akosturi/bitsynth/schematic/wiring.jpg

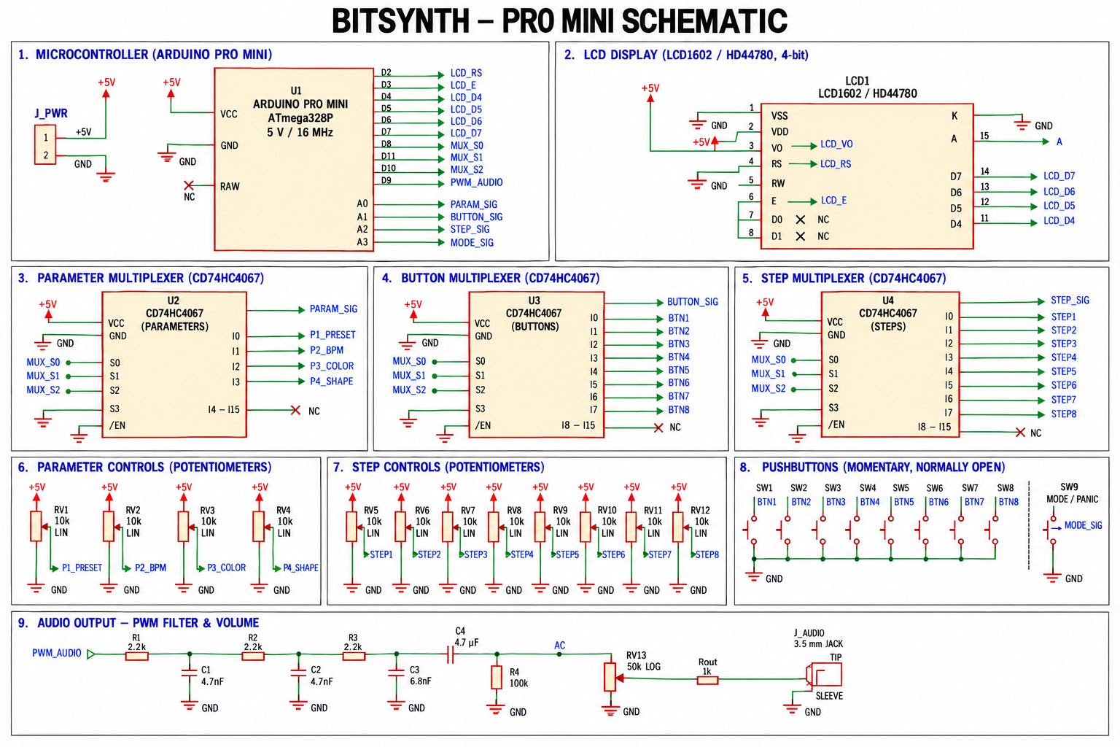
schematic/wiring.jpg
