akosturi/bitsynth/03.jpg

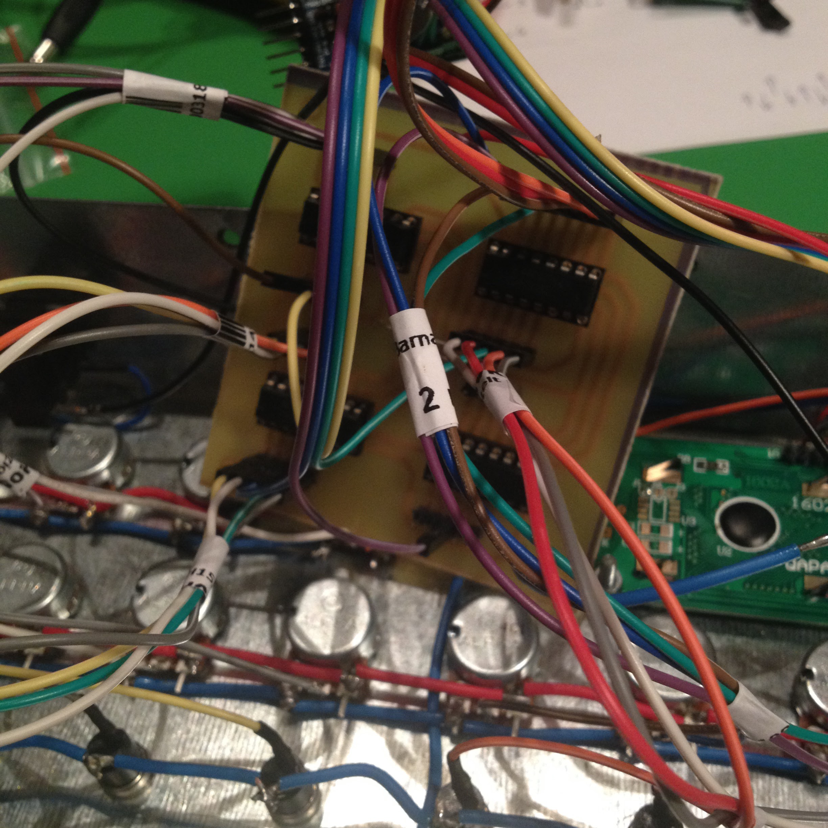
03.jpg
