akosturi/bitsynth/01.jpg

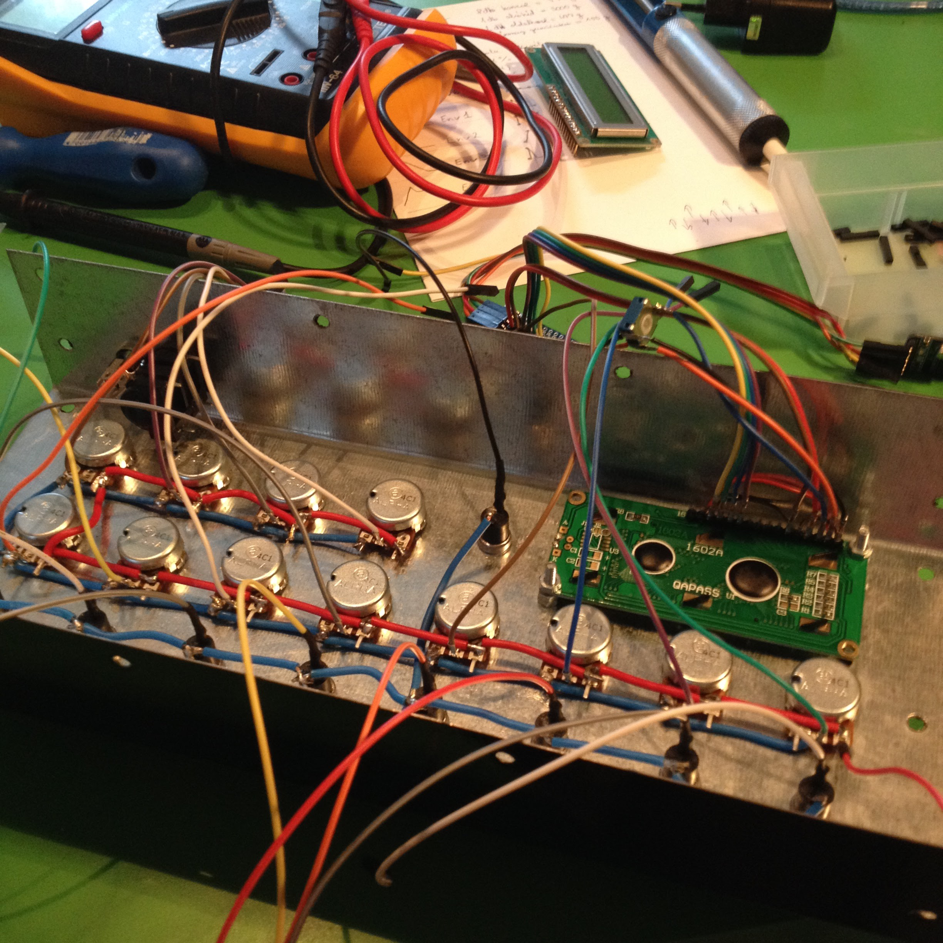
01.jpg
