akosturi/bitsynth/02.jpg

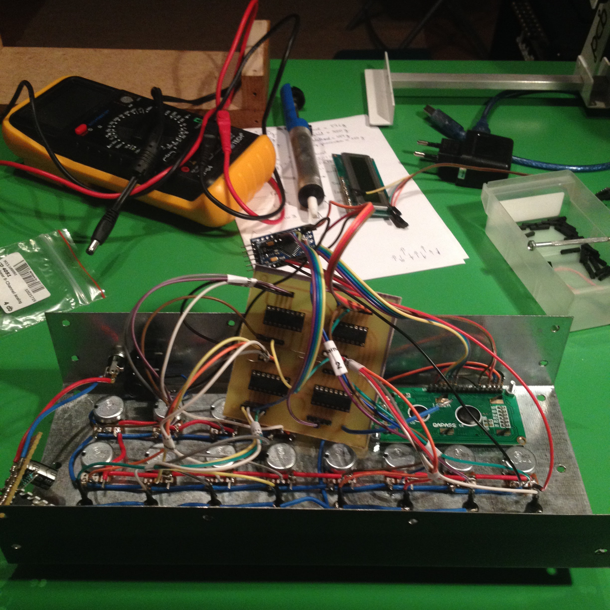
02.jpg
