akosturi/bitsynth/schematic/envelopes.jpg

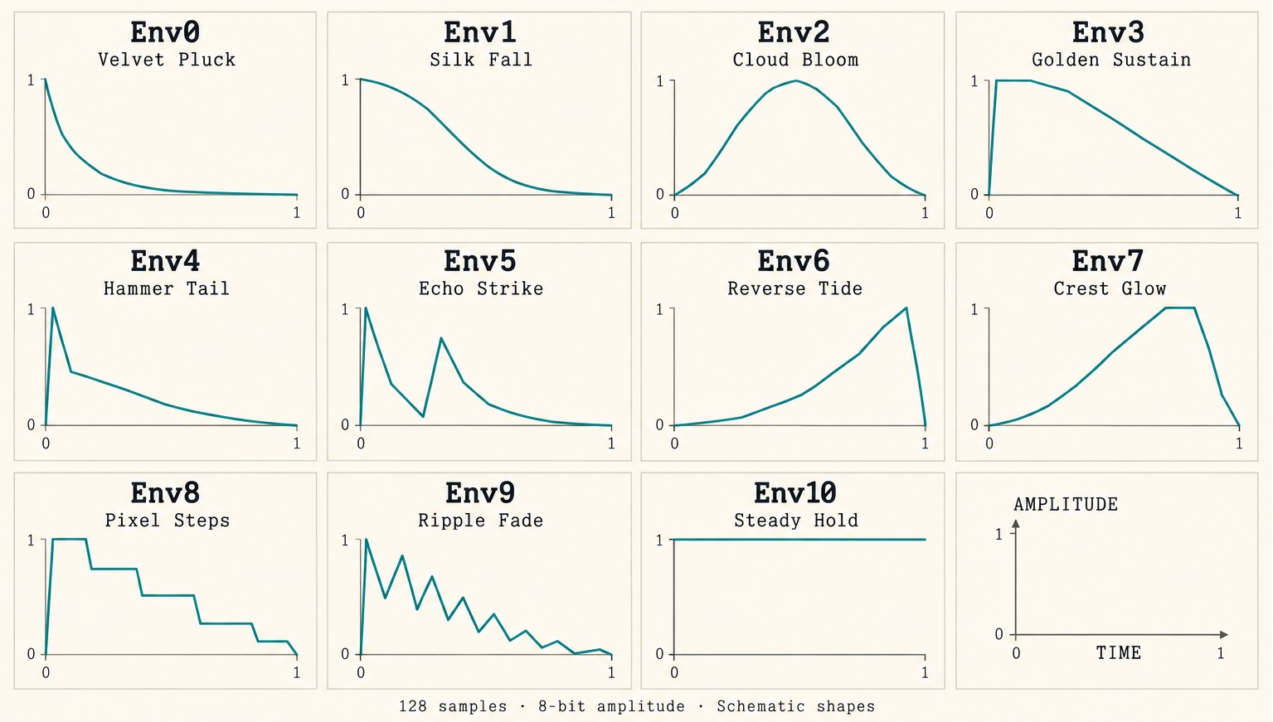
schematic/envelopes.jpg
