akosturi/bitsynth/schematic/wiring.kicad_pcb

## KiCad design schematic/wiring.kicad_pcb (2026-10-29)

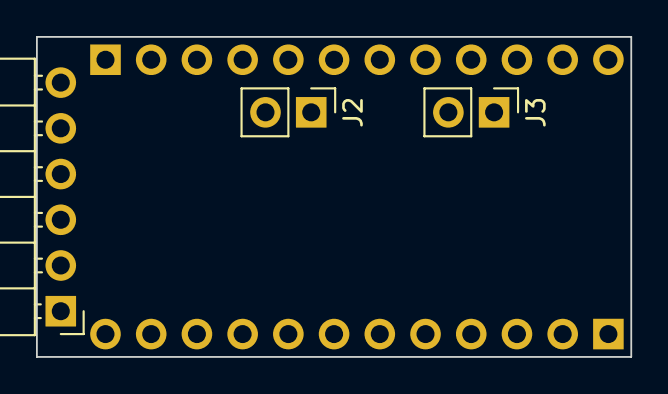
[picture p6: board wiring.kicad_pcb from above]

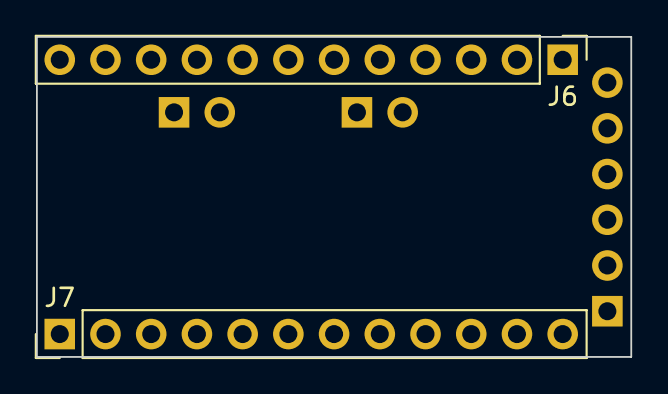
[picture p7: board wiring.kicad_pcb from below]

Board: 2 copper layers, 33.0 x 17.8 mm, 5 parts (2 on the bottom side), 5 nets, no tracks yet.

Parts:
J1: FTDI; PinHeader_1x06_P2.54mm_Horizontal
J2: I2C; PinHeader_1x02_P2.54mm_Vertical
J3: Analog; PinHeader_1x02_P2.54mm_Vertical
J6: Analog; PinHeader_1x12_P2.54mm_Vertical
J7: Digital; PinHeader_1x12_P2.54mm_Vertical

Connections:
/RX: J1.4, J7.11
/TX: J1.5, J7.12
/~RESET: J6.3, J7.10
GND: J1.1, J1.2, J6.2, J7.9
VCC: J1.3, J6.4
