akosturi/bitsynth/src/synth.h

#ifndef _SYNTH
#define _SYNTH
#include <Arduino.h>
#include <avr/pgmspace.h>
#include <avr/interrupt.h>
#include <util/atomic.h>
#include "tables.h"

#ifndef F_CPU
#define F_CPU 16000000UL
#endif

#define DIFF 1
#define CHA 2
#define CHB 3

#define SINE     0
#define TRIANGLE 1
#define SQUARE   2
#define SAW      3
#define NOISE    4

#define ENVELOPE0 0
#define ENVELOPE1 1
#define ENVELOPE2 2
#define ENVELOPE3 3
#define ENVELOPE4 4
#define ENVELOPE5 5
#define ENVELOPE6 6
#define ENVELOPE7 7

#define FS 20000UL

#if defined(SYNTH_FIXED_OUTPUT_MODE) && \
    SYNTH_FIXED_OUTPUT_MODE != DIFF && \
    SYNTH_FIXED_OUTPUT_MODE != CHA && \
    SYNTH_FIXED_OUTPUT_MODE != CHB
#error "SYNTH_FIXED_OUTPUT_MODE must be DIFF, CHA, or CHB"
#endif

static_assert(kickSampleRate == FS, "kick sample rate must match the 20 kHz audio engine");
static_assert(snareSampleRate == FS, "snare sample rate must match the 20 kHz audio engine");
static_assert(hihatSampleRate == FS, "hi-hat sample rate must match the 20 kHz audio engine");
static_assert(kickSampleBits == 9, "kick sample must use unsigned 9-bit PCM");
static_assert(snareSampleBits == 9, "snare sample must use unsigned 9-bit PCM");
static_assert(hihatSampleBits == 9, "hi-hat sample must use unsigned 9-bit PCM");
// One trailing byte makes the final unaligned 16-bit flash read safe.
static_assert(sizeof(kickSample) == (kickSampleLength * 9U + 7U) / 8U + 1U, "invalid packed kick sample size");
static_assert(sizeof(snareSample) == (snareSampleLength * 9U + 7U) / 8U + 1U, "invalid packed snare sample size");
static_assert(sizeof(hihatSample) == (hihatSampleLength * 9U + 7U) / 8U + 1U, "invalid packed hi-hat sample size");

#define SET(x,y) (x |= (1 << y))
#define CLR(x,y) (x &= (~(1 << y)))

const uint8_t SYNTH_VOICE_COUNT = 4;
const uint8_t SYNTH_DRONE_COUNT = 8;
const uint8_t SYNTH_MIDI_NOTE_MAX = 127;
const uint8_t SYNTH_LENGTH_MAX = 127;
const uint8_t SYNTH_ENVELOPE_COUNT = 6;
const uint8_t SYNTH_WAVETABLE_INDEX_BITS = 8;
const uint8_t SYNTH_WAVETABLE_SHIFT = 16 - SYNTH_WAVETABLE_INDEX_BITS;
const uint16_t SYNTH_GENERATED_SQUARE = 0;
// Flash on this target cannot reach this address; reserve it as a generated
// source marker rather than spending flash on a noise wavetable.
const uint16_t SYNTH_GENERATED_NOISE = 0xFFFF;
const uint16_t SYNTH_DEFAULT_PULSE_WIDTH = 0x8000;
// Updated once per four audio frames (5 kHz), giving a fixed 5 Hz vibrato.
const uint32_t SYNTH_VIBRATO_LFO_STEP = 4294967UL;
const uint8_t SYNTH_CHORUS_OFF = 0;
const uint8_t SYNTH_CHORUS_1 = 1;
const uint8_t SYNTH_CHORUS_2 = 2;
// Juno-60-style triangle-modulated delay parameters at the 20 kHz engine rate.
const uint16_t SYNTH_CHORUS_BUFFER_SAMPLES = 108;
const uint32_t SYNTH_CHORUS_1_LFO_STEP = 110166UL; // 0.513 Hz
const uint32_t SYNTH_CHORUS_2_LFO_STEP = 185328UL; // 0.863 Hz
const uint16_t SYNTH_CHORUS_MIN_DELAY_Q8 = 8500; // 1.66 ms

static_assert(sizeof(SinTable) / sizeof(SinTable[0]) == (1U << SYNTH_WAVETABLE_INDEX_BITS), "invalid sine table size");
static_assert(sizeof(TriangleTable) / sizeof(TriangleTable[0]) == (1U << SYNTH_WAVETABLE_INDEX_BITS), "invalid triangle table size");
static_assert(sizeof(SawTable) / sizeof(SawTable[0]) == (1U << SYNTH_WAVETABLE_INDEX_BITS), "invalid saw table size");

volatile uint16_t PCW[SYNTH_VOICE_COUNT] = {0, 0, 0, 0};
volatile uint16_t FTW[SYNTH_VOICE_COUNT] = {1000, 200, 300, 400};
volatile uint8_t AMP[SYNTH_VOICE_COUNT] = {0, 0, 0, 0};
volatile uint16_t PITCH[SYNTH_VOICE_COUNT] = {500, 500, 500, 500};
volatile int8_t MOD[SYNTH_VOICE_COUNT] = {0, 0, 0, 0};
volatile uint32_t vibratoLfoPCW = 0x40000000UL;
volatile uint16_t waveSources[SYNTH_VOICE_COUNT] = {
  (uint16_t)SinTable, (uint16_t)SinTable, (uint16_t)SinTable, (uint16_t)SinTable
};
// Full phase resolution makes pulse width independent from wavetable size.
volatile uint16_t pulseWidths[SYNTH_VOICE_COUNT] = {
  SYNTH_DEFAULT_PULSE_WIDTH, SYNTH_DEFAULT_PULSE_WIDTH,
  SYNTH_DEFAULT_PULSE_WIDTH, SYNTH_DEFAULT_PULSE_WIDTH
};
volatile uint16_t envs[SYNTH_VOICE_COUNT] = {
  (uint16_t)Env0, (uint16_t)Env0, (uint16_t)Env0, (uint16_t)Env0
};
volatile uint16_t EPCW[SYNTH_VOICE_COUNT] = {0x8000, 0x8000, 0x8000, 0x8000};
volatile uint16_t EFTW[SYNTH_VOICE_COUNT] = {10, 10, 10, 10};
volatile uint8_t divider = 4;
volatile int16_t pwmQuantizationError = 0;
volatile uint8_t pwmDitherLfsr = 0xA5;
// Independent maximal-length 16-bit Galois LFSRs for the four normal voices.
// These are advanced only by the audio ISR and must never be seeded with zero.
volatile uint16_t noiseLfsrs[SYNTH_VOICE_COUNT] = {
  0xA5C3, 0xD72B, 0x9E37, 0xF1A5
};
// Retained performance engines. Their UI routing is intentionally disabled
// for now, but presets still configure the VCA defaults.
volatile bool playMorphActive = false;
volatile uint16_t playMorphSource = (uint16_t)SinTable;
volatile uint32_t playMorphLfoPCW = 0x80000000UL;
volatile uint32_t playMorphLfoFTW = 0;
volatile uint8_t playMorphAmount = 128;
volatile uint16_t playVcaGain = 256;
volatile uint16_t playVcaAttenuationDepth = 0;
volatile uint32_t playVcaLfoPCW = 0x80000000UL;
volatile uint32_t playVcaLfoFTW = 0;
uint8_t playLfoDivider = 0;
volatile bool droneMode = false;
volatile uint16_t dronePCW[SYNTH_DRONE_COUNT] = {0, 0, 0, 0, 0, 0, 0, 0};
volatile uint16_t droneFTW[SYNTH_DRONE_COUNT] = {0, 0, 0, 0, 0, 0, 0, 0};
volatile uint16_t droneWaveSources[SYNTH_DRONE_COUNT] = {
  (uint16_t)SinTable, (uint16_t)SinTable, (uint16_t)SinTable, (uint16_t)SinTable,
  (uint16_t)SinTable, (uint16_t)SinTable, (uint16_t)SinTable, (uint16_t)SinTable
};
volatile uint8_t droneAmp[SYNTH_DRONE_COUNT] = {0, 0, 0, 0, 0, 0, 0, 0};
volatile uint8_t droneTargetAmp[SYNTH_DRONE_COUNT] = {0, 0, 0, 0, 0, 0, 0, 0};
volatile uint8_t droneRampVoice = 0;
volatile uint8_t droneMixPair = 0;
volatile int16_t dronePairMixQ7[SYNTH_DRONE_COUNT / 2] = {0, 0, 0, 0};
volatile uint32_t droneLfoPCW[SYNTH_DRONE_COUNT / 2] = {0, 0, 0, 0};
volatile uint32_t droneLfoFTW[SYNTH_DRONE_COUNT / 2] = {0, 0, 0, 0};
volatile bool drumActive = false;
volatile uint16_t drumSampleAddress = 0;
volatile uint16_t drumSampleLength = 0;
volatile uint32_t drumSamplePhase = 0;
volatile uint32_t drumSampleStep = 0x10000UL;
volatile uint16_t drumEnvelope = 0;
volatile uint16_t drumEnvelopeStep = 1;
// One 16-bit Q7 mono delay line, written only by the audio ISR. It stores the
// wet half of the signal, so interpolating adjacent samples stays in int16_t.
int16_t chorusBuffer[SYNTH_CHORUS_BUFFER_SAMPLES] = {0};
volatile bool chorusActive = false;
volatile bool chorusLiveOnly = false;
volatile uint16_t chorusWriteIndex = 0;
volatile uint32_t chorusLfoPCW = 0;
volatile uint32_t chorusLfoFTW = 0;

static inline __attribute__((always_inline)) int16_t readSigned9Sample(
  uint16_t sampleAddress, uint16_t sampleIndex)
{
  return (int16_t)pgm_read_word(sampleAddress + (sampleIndex << 1));
}

static inline __attribute__((always_inline)) int16_t generatedSquareSample(
  uint16_t phase, uint16_t pulseWidth)
{
  return phase < pulseWidth ? 255 : -256;
}

static inline __attribute__((always_inline)) int16_t nextNoiseSample(uint8_t voice)
{
  const uint16_t state = noiseLfsrs[voice];
  const uint16_t next = (state >> 1) ^ ((state & 1) ? 0xB400 : 0);
  noiseLfsrs[voice] = next;
  return (int16_t)(next & 0x01FF) - 256;
}

static inline __attribute__((always_inline)) int16_t nextWaveSample(
  uint8_t voice, uint16_t source, uint16_t phase, uint16_t pulseWidth)
{
  if (source == SYNTH_GENERATED_SQUARE) {
    return generatedSquareSample(phase, pulseWidth);
  }
  if (source == SYNTH_GENERATED_NOISE) {
    return nextNoiseSample(voice);
  }
  return readSigned9Sample(source, phase >> SYNTH_WAVETABLE_SHIFT);
}

// Decodes an offset-binary unsigned 9-bit sample packed across byte boundaries.
static inline __attribute__((always_inline)) int16_t readPackedUnsigned9Sample(
  uint16_t sampleAddress, uint16_t sampleIndex)
{
  const uint16_t byteIndex = sampleIndex + (sampleIndex >> 3);
  const uint8_t shift = sampleIndex & 0x07;
  const uint16_t packed = pgm_read_word(sampleAddress + byteIndex);
  const uint16_t encoded = (packed >> shift) & 0x01FF;
  return (int16_t)encoded - 256;
}

// Scales a signed sample with arithmetic-shift rounding.
static inline __attribute__((always_inline)) int16_t scaleSigned9Sample(
  int16_t sample, uint8_t gain, uint8_t shift)
{
  const bool negative = sample < 0;
  const uint16_t magnitude = negative ? -sample : sample;
  uint16_t product = magnitude * gain;
  if (negative) {
    product += (1U << shift) - 1U;
    return -(int16_t)(product >> shift);
  }
  return product >> shift;
}

// Keeps phase continuity for silent voices without reading or scaling a table.
static inline __attribute__((always_inline)) int16_t nextScaledVoiceSample(
  uint8_t voice, uint8_t gain)
{
  const uint16_t phase = PCW[voice] + FTW[voice];
  PCW[voice] = phase;
  if (gain == 0) {
    return 0;
  }
  const uint16_t source = waveSources[voice];
  const int16_t sample = nextWaveSample(voice, source, phase, pulseWidths[voice]);
  return scaleSigned9Sample(sample, gain, 3);
}

static inline __attribute__((always_inline)) int16_t nextScaledMorphedVoiceSample(
  uint8_t voice, uint16_t secondarySource, uint8_t morphAmount, uint8_t gain)
{
  const uint16_t phase = PCW[voice] + FTW[voice];
  PCW[voice] = phase;
  if (gain == 0) return 0;
  const int16_t sampleA = nextWaveSample(voice, waveSources[voice], phase, pulseWidths[voice]);
  const int16_t sampleB = nextWaveSample(voice, secondarySource, phase, pulseWidths[voice]);
  const uint8_t primaryAmount = 128 - morphAmount;
  return scaleSigned9Sample(((sampleA * primaryAmount) + (sampleB * morphAmount)) >> 7, gain, 3);
}

// Applies a 9-bit linear gain with error far below one PWM output step.
static inline __attribute__((always_inline)) int16_t scalePlayMix(
  int16_t inputQ7, uint8_t gain)
{
  if (gain == 0) return 0;

  const bool negative = inputQ7 < 0;
  const uint16_t magnitude = negative ? -inputQ7 : inputQ7;
  const uint8_t magnitudeHigh = magnitude >> 8;
  const uint8_t magnitudeLow = magnitude;
  const uint8_t halfGain = gain >> 1;
  const uint16_t highProduct =
    __builtin_avr_fmul(magnitudeHigh, gain) >> 1;
  const uint16_t lowProduct =
    __builtin_avr_fmul(magnitudeLow, halfGain);
  const uint16_t scaled = highProduct + ((lowProduct + 128) >> 8);
  return negative ? -(int16_t)scaled : scaled;
}

// Computes value / 64 without slow wide shifts on AVR.
static inline __attribute__((always_inline)) uint16_t modulationCoarse(uint16_t value)
{
  const uint8_t high = value >> 8;
  const uint8_t low = (uint8_t)value / 64U;
  return ((uint16_t)high << 2) | low;
}

// Applies the post-mix chorus with Q8 fractional addressing and audio-rate
// delay modulation.
static inline __attribute__((always_inline)) int16_t applyChorus(int16_t inputQ7)
{
  const uint32_t phase = chorusLfoPCW + chorusLfoFTW;
  chorusLfoPCW = phase;
  uint16_t triangle = phase >> 16;
  if (phase & 0x80000000UL) triangle = 0xFFFFU - triangle;
  // 18892 / 32768 is approximated by shifts, keeping the full delay range
  // within 0.001 ms of the requested 1.66-5.35 ms span without a wide multiply.
  const uint16_t delayQ8 = SYNTH_CHORUS_MIN_DELAY_Q8 + (triangle >> 1) +
    (triangle >> 4) + (triangle >> 7) + (triangle >> 8) + (triangle >> 9) +
    (triangle >> 12);
  const uint16_t delaySamples = delayQ8 >> 8;
  const uint16_t writeIndex = chorusWriteIndex;
  chorusBuffer[writeIndex] = inputQ7 >> 1;
  chorusWriteIndex = writeIndex + 1 == SYNTH_CHORUS_BUFFER_SAMPLES ?
    0 : writeIndex + 1;

  const uint16_t readIndex = writeIndex >= delaySamples ?
    writeIndex - delaySamples : writeIndex + SYNTH_CHORUS_BUFFER_SAMPLES - delaySamples;
  const uint16_t nextIndex = readIndex == 0 ?
    SYNTH_CHORUS_BUFFER_SAMPLES - 1 : readIndex - 1;
  const int16_t first = chorusBuffer[readIndex];
  const int16_t difference = (int16_t)chorusBuffer[nextIndex] - first;
  const int16_t delayed = first +
    (int16_t)(((int32_t)difference * (uint8_t)delayQ8) >> 8);
  return (inputQ7 >> 1) + delayed;
}

// Mixes one audio frame and updates time-sliced synthesis state.
// O2 avoids slow size-optimized shift loops in this ISR.
ISR(TIMER2_COMPA_vect, __attribute__((optimize("O2"))))
{
  const uint8_t voiceIndex = (divider + 1) & 0x03;
  divider = voiceIndex;
  const bool renderDrone = droneMode;

  int16_t mixQ7;

  if (renderDrone) {
    const uint8_t rampVoice = (droneRampVoice + 1) & 0x07;
    droneRampVoice = rampVoice;
    uint8_t amplitude = droneAmp[rampVoice];
    const uint8_t target = droneTargetAmp[rampVoice];
    if (amplitude < target) {
      amplitude = (target - amplitude > 15) ? amplitude + 15 : target;
    } else if (amplitude > target) {
      amplitude = (amplitude - target > 15) ? amplitude - 15 : target;
    }
    droneAmp[rampVoice] = amplitude;

    const uint8_t pair = (droneMixPair + 1) & 0x03;
    droneMixPair = pair;
    int16_t pairMixQ7 = 0;
    const uint8_t firstVoice = pair << 1;
    for (uint8_t voice = firstVoice; voice < firstVoice + 2; ++voice) {
      amplitude = droneAmp[voice];
      if (amplitude != 0) {
        const uint16_t phase = dronePCW[voice] += droneFTW[voice] << 2;
        const uint16_t source = droneWaveSources[voice];
        const int16_t sample = source == SYNTH_GENERATED_SQUARE ?
          generatedSquareSample(phase, SYNTH_DEFAULT_PULSE_WIDTH) :
          readSigned9Sample(source, phase >> SYNTH_WAVETABLE_SHIFT);
        pairMixQ7 += scaleSigned9Sample(sample, amplitude, 4);
      }
    }

    const uint32_t lfoStep = droneLfoFTW[pair];
    if (lfoStep != 0) {
      const uint32_t lfoPhase = droneLfoPCW[pair] + lfoStep;
      droneLfoPCW[pair] = lfoPhase;
      const uint8_t trianglePhase = (uint8_t)(lfoPhase >> 24);
      const uint8_t triangleAmount = (trianglePhase & 0x80) ?
        (uint8_t)(256U - trianglePhase) : trianglePhase;
      const uint16_t gain = (uint16_t)triangleAmount << 1;
      if (gain < 256) {
        pairMixQ7 = scalePlayMix(pairMixQ7, (uint8_t)gain);
      }
    }
    dronePairMixQ7[pair] = pairMixQ7;
    mixQ7 = dronePairMixQ7[0] + dronePairMixQ7[1] +
      dronePairMixQ7[2] + dronePairMixQ7[3];
  } else {
    if (voiceIndex == 0) {
      vibratoLfoPCW += SYNTH_VIBRATO_LFO_STEP;
    }
    const uint8_t vibratoPhase = ((uint8_t*)&vibratoLfoPCW)[3];
    const uint8_t vibratoTriangle = (vibratoPhase & 0x80) ?
      (uint8_t)(256U - vibratoPhase) : vibratoPhase;
    // Center the triangle at zero and halve it to keep the pitch math 16-bit.
    const int8_t vibratoLfo = (int8_t)(vibratoTriangle >> 1) - 32;

    const uint16_t envelopePhase = EPCW[voiceIndex];
    if (envelopePhase & 0x8000) {
      AMP[voiceIndex] = 0;
    } else {
      const uint16_t nextEnvelopePhase = envelopePhase + EFTW[voiceIndex];
      EPCW[voiceIndex] = nextEnvelopePhase;
      const uint8_t envelopeIndex = nextEnvelopePhase >> 8;
      AMP[voiceIndex] = (envelopeIndex & 0x80) ? 0 :
        pgm_read_byte(envs[voiceIndex] + envelopeIndex);
    }

    bool updatePlayVcaLfo = false;
    bool updatePlayMorphLfo = false;
    if (voiceIndex == 0) {
      playLfoDivider ^= 1;
      updatePlayVcaLfo = playLfoDivider == 0;
      updatePlayMorphLfo = !updatePlayVcaLfo;
    }
    if (updatePlayVcaLfo && playVcaLfoFTW != 0) {
      playVcaLfoPCW += playVcaLfoFTW;
      const uint8_t phase = ((uint8_t*)&playVcaLfoPCW)[3];
      const uint8_t triangle = (phase & 0x80) ? (uint8_t)(256U - phase) : phase;
      const uint16_t attenuation = (playVcaAttenuationDepth * triangle + 64) >> 7;
      playVcaGain = 256 - attenuation;
    }

    int16_t sourceZeroQ7 = 0;
    bool renderDrum = drumActive;
    if (renderDrum) {
      const uint32_t samplePhase = drumSamplePhase;
      const uint16_t envelope = drumEnvelope;
      const uint16_t sampleIndex = samplePhase >> 16;
      if (sampleIndex >= drumSampleLength || envelope == 0) {
        drumEnvelope = 0;
        drumActive = false;
        renderDrum = false;
      } else {
        const int16_t sample = readPackedUnsigned9Sample(drumSampleAddress, sampleIndex);
        drumSamplePhase = samplePhase + drumSampleStep;
        const uint8_t gain = envelope >> 8;
        sourceZeroQ7 = scaleSigned9Sample(sample, gain, 3);
        const uint16_t envelopeStep = drumEnvelopeStep;
        drumEnvelope = envelope <= envelopeStep ? 0 : envelope - envelopeStep;
      }
    } else {
      sourceZeroQ7 = nextScaledVoiceSample(0, AMP[0]);
    }

    int16_t liveMixQ7;
    if (playMorphActive) {
      if (updatePlayMorphLfo) {
        playMorphLfoPCW += playMorphLfoFTW;
        const uint8_t phase = ((uint8_t*)&playMorphLfoPCW)[3];
        playMorphAmount = (phase & 0x80) ? (uint8_t)(256U - phase) : phase;
      }
      liveMixQ7 = nextScaledMorphedVoiceSample(1, playMorphSource, playMorphAmount, AMP[1]) +
        nextScaledMorphedVoiceSample(2, playMorphSource, playMorphAmount, AMP[2]) +
        nextScaledMorphedVoiceSample(3, playMorphSource, playMorphAmount, AMP[3]);
    } else {
      liveMixQ7 = nextScaledVoiceSample(1, AMP[1]) + nextScaledVoiceSample(2, AMP[2]) +
        nextScaledVoiceSample(3, AMP[3]);
    }
    const int16_t scaledLiveMixQ7 = playVcaGain >= 256 ? liveMixQ7 :
      scalePlayMix(liveMixQ7, (uint8_t)playVcaGain);
    mixQ7 = sourceZeroQ7 + (chorusActive && chorusLiveOnly ?
      applyChorus(scaledLiveMixQ7) : scaledLiveMixQ7);

    if (!renderDrum || voiceIndex != 0) {
      const uint16_t pitch = PITCH[voiceIndex];
      const int8_t modulation = MOD[voiceIndex];
      const uint8_t vibratoDepth = modulation < 0 ? -modulation : modulation;
      if (vibratoDepth == 0) {
        FTW[voiceIndex] = pitch;
      } else {
        // Full depth is about +/- 6% of pitch.  MOD is a depth, so values on
        // either side of 64 produce the same centered, continuous vibrato.
        const uint16_t peakOffset =
          (modulationCoarse(pitch) * vibratoDepth) >> 4;
        const int16_t pitchOffset =
          ((int16_t)peakOffset * (int16_t)vibratoLfo) >> 5;
        FTW[voiceIndex] = pitch + pitchOffset;
      }
    }
  }

  if (!renderDrone && chorusActive && !chorusLiveOnly) {
    mixQ7 = applyChorus(mixQ7);
  }

  const uint8_t feedback = (pwmDitherLfsr & 0x01) ? 0xB8 : 0x00;
  const uint8_t lfsr = (pwmDitherLfsr >> 1) ^ feedback;
  pwmDitherLfsr = lfsr;
  const uint8_t highNibble = lfsr / 16U;
  const int16_t dither =
    ((int8_t)(lfsr & 0x0F) - (int8_t)highNibble) << 2;
  mixQ7 += pwmQuantizationError + dither;

  const int16_t quantizedMix = (mixQ7 + 64) >> 7;
  pwmQuantizationError = mixQ7 - (quantizedMix << 7);

  int16_t nextPwmSample = 256 + quantizedMix;
  if (nextPwmSample < 0) {
    nextPwmSample = 0;
  } else if (nextPwmSample > 511) {
    nextPwmSample = 511;
  }
  const uint16_t pwmSample = (uint16_t)nextPwmSample;

#if defined(SYNTH_FIXED_OUTPUT_MODE)
  #if SYNTH_FIXED_OUTPUT_MODE == CHA
    OCR1A = pwmSample;
  #elif SYNTH_FIXED_OUTPUT_MODE == CHB
    OCR1B = pwmSample;
  #else
    OCR1A = OCR1B = pwmSample;
  #endif
#else
  OCR1A = OCR1B = pwmSample;
#endif

}

class synth
{
  private:
    uint16_t waveSource(uint8_t wave) const
    {
      switch (wave)
      {
        case TRIANGLE:
          return (uint16_t)TriangleTable;
        case SQUARE:
          return SYNTH_GENERATED_SQUARE;
        case SAW:
          return (uint16_t)SawTable;
        case NOISE:
          return SYNTH_GENERATED_NOISE;
        case SINE:
        default:
          return (uint16_t)SinTable;
      }
    }

    bool validVoice(uint8_t voice) const
    {
      return voice < SYNTH_VOICE_COUNT;
    }

    void configureTimer2()
    {
      TCCR2A = (1 << WGM21);
      TCCR2B = (1 << CS21);
      TCNT2 = 0;
      OCR2A = (uint8_t)((F_CPU / (8UL * FS)) - 1);
    }

    void enableTimer2Interrupt()
    {
      SET(TIMSK2, OCIE2A);
    }

    void configureTimer1Pwm()
    {
      TCCR1A = (1 << WGM11);
      TCCR1B = (1 << WGM12) | (1 << CS10);
      TCCR1C = 0x00;
      TCNT1 = 0;
      OCR1A = OCR1B = 256;
    }

    void configureChaOutput()
    {
      configureTimer1Pwm();
      SET(TCCR1A, COM1A1);
      CLR(TCCR1A, COM1A0);
      SET(DDRB, 1);
    }

    void configureChbOutput()
    {
      configureTimer1Pwm();
      SET(TCCR1A, COM1B1);
      CLR(TCCR1A, COM1B0);
      SET(DDRB, 2);
    }

    void configureDifferentialOutput()
    {
      configureTimer1Pwm();
      SET(TCCR1A, COM1A1);
      CLR(TCCR1A, COM1A0);
      SET(TCCR1A, COM1B1);
      SET(TCCR1A, COM1B0);
      SET(DDRB, 1);
      SET(DDRB, 2);
    }

  public:
    synth()
    {
    }

    // Starts the audio timers with the selected PWM output mode.
    void begin(uint8_t outputMode)
    {
      cli();
      configureTimer2();

#ifdef SYNTH_FIXED_OUTPUT_MODE
      outputMode = SYNTH_FIXED_OUTPUT_MODE;
#endif

      switch (outputMode)
      {
        case DIFF:
          configureDifferentialOutput();
          break;
        case CHB:
          configureChbOutput();
          break;
        case CHA:
        default:
          configureChaOutput();
          break;
      }

      enableTimer2Interrupt();
      sei();
    }

    // Configures all parameters of one melodic voice.
    void setupVoice(uint8_t voice, uint8_t wave, uint8_t pitch, uint8_t env, uint8_t length, uint8_t mod)
    {
      setWave(voice, wave);
      setPitch(voice, pitch);
      setEnvelope(voice, env);
      setLength(voice, length);
      setMod(voice, mod);
    }

    void setWave(uint8_t voice, uint8_t wave)
    {
      if (!validVoice(voice)) {
        return;
      }

      const uint16_t selectedWave = waveSource(wave);

      ATOMIC_BLOCK(ATOMIC_RESTORESTATE) {
        waveSources[voice] = selectedWave;
      }
    }

    // Pulse width is the high portion of the 16-bit oscillator phase.
    void setPulseWidth(uint8_t voice, uint16_t pulseWidth)
    {
      if (!validVoice(voice)) return;
      ATOMIC_BLOCK(ATOMIC_RESTORESTATE) {
        pulseWidths[voice] = pulseWidth;
      }
    }

    // Kept available for a future UI route; no current control calls it.
    void configurePlayMorph(uint8_t primaryWave, uint8_t secondaryWave,
      uint16_t frequencyHundredths, bool secondaryEnabled)
    {
      const uint16_t primary = waveSource(primaryWave);
      const uint16_t secondary = waveSource(secondaryWave);
      const uint32_t step = frequencyHundredths == 0 ? 0 : (uint32_t)frequencyHundredths * 17180UL;
      const bool active = secondaryEnabled && step != 0;
      ATOMIC_BLOCK(ATOMIC_RESTORESTATE) {
        for (uint8_t voice = 1; voice < SYNTH_VOICE_COUNT; ++voice) waveSources[voice] = active || !secondaryEnabled ? primary : secondary;
        playMorphSource = secondary;
        playMorphLfoFTW = step;
        if (!active) playMorphAmount = 128;
        playMorphActive = active;
      }
    }

    void disablePlayMorph() {
      ATOMIC_BLOCK(ATOMIC_RESTORESTATE) { playMorphActive = false; playMorphLfoFTW = 0; playMorphAmount = 128; }
    }

    void configurePlayVca(uint16_t depth, uint16_t frequencyHundredths)
    {
      if (depth > 256) depth = 256;
      const uint32_t step = depth == 0 || frequencyHundredths == 0 ? 0 : (uint32_t)frequencyHundredths * 17180UL;
      ATOMIC_BLOCK(ATOMIC_RESTORESTATE) {
        const bool wasActive = playVcaLfoFTW != 0;
        playVcaAttenuationDepth = depth;
        playVcaLfoFTW = step;
        if (step == 0) {
          playVcaLfoPCW = 0x80000000UL;
          playVcaGain = 256 - depth;
        } else if (!wasActive) {
          playVcaLfoPCW = 0x80000000UL;
          playVcaGain = 256 - depth;
        }
      }
    }

    void disablePlayVca() {
      ATOMIC_BLOCK(ATOMIC_RESTORESTATE) { playVcaAttenuationDepth = 0; playVcaGain = 256; playVcaLfoFTW = 0; }
    }

    void setPitch(uint8_t voice, uint8_t midiNote)
    {
      if (!validVoice(voice)) {
        return;
      }

      if (midiNote > SYNTH_MIDI_NOTE_MAX) {
        midiNote = SYNTH_MIDI_NOTE_MAX;
      }

      setPitchWord(voice, pgm_read_word(&PITCHS[midiNote]));
    }

    void setPitchWord(uint8_t voice, uint16_t pitch)
    {
      if (!validVoice(voice)) {
        return;
      }

      ATOMIC_BLOCK(ATOMIC_RESTORESTATE) {
        PITCH[voice] = pitch;
      }
    }

    void setEnvelope(uint8_t voice, uint8_t env)
    {
      if (!validVoice(voice)) {
        return;
      }

      uint16_t selectedEnvelope = (uint16_t)Env0;
      switch (env)
      {
        case ENVELOPE1:
          selectedEnvelope = (uint16_t)Env1;
          break;
        case ENVELOPE2:
          selectedEnvelope = (uint16_t)Env2;
          break;
        case ENVELOPE3:
          selectedEnvelope = (uint16_t)Env3;
          break;
        case ENVELOPE4:
          selectedEnvelope = (uint16_t)Env4;
          break;
        case ENVELOPE5:
          selectedEnvelope = (uint16_t)Env5;
          break;
      }

      ATOMIC_BLOCK(ATOMIC_RESTORESTATE) {
        envs[voice] = selectedEnvelope;
      }
    }

    void setLength(uint8_t voice, uint8_t length)
    {
      if (!validVoice(voice)) {
        return;
      }

      if (length > SYNTH_LENGTH_MAX) {
        length = SYNTH_LENGTH_MAX;
      }

      const uint16_t envelopeSpeed = pgm_read_word(&EFTWS[length]);
      ATOMIC_BLOCK(ATOMIC_RESTORESTATE) {
        EFTW[voice] = envelopeSpeed;
      }
    }

    // Sets vibrato depth with 64 as neutral; either direction has equal depth.
    void setMod(uint8_t voice, uint8_t mod)
    {
      if (!validVoice(voice)) {
        return;
      }

      if (mod > 127) {
        mod = 127;
      }

      ATOMIC_BLOCK(ATOMIC_RESTORESTATE) {
        MOD[voice] = (int16_t)mod - 64;
      }
    }

    void trigger(uint8_t voice)
    {
      if (!validVoice(voice)) {
        return;
      }

      ATOMIC_BLOCK(ATOMIC_RESTORESTATE) {
        EPCW[voice] = 0;
        FTW[voice] = PITCH[voice];
      }
    }

    void stopVoice(uint8_t voice)
    {
      if (!validVoice(voice)) {
        return;
      }

      ATOMIC_BLOCK(ATOMIC_RESTORESTATE) {
        EPCW[voice] = 0x8000;
        AMP[voice] = 0;
        FTW[voice] = 0;
      }
    }

    // Starts packed sample playback with tone and decay scaling.
    void triggerDrum(uint8_t type, uint8_t tone, uint8_t decay)
    {
      if (type >= DRUM_SAMPLE_COUNT) type = DRUM_SAMPLE_COUNT - 1;
      if (tone > 127) tone = 127;
      if (decay > 127) decay = 127;

      uint16_t sampleAddress;
      uint16_t sampleLength;
      if (type == 0) {
        sampleAddress = (uint16_t)kickSample;
        sampleLength = kickSampleLength;
      } else if (type == 1) {
        sampleAddress = (uint16_t)snareSample;
        sampleLength = snareSampleLength;
      } else {
        sampleAddress = (uint16_t)hihatSample;
        sampleLength = hihatSampleLength;
      }

      const uint32_t sampleStep = 49152UL +
        (((uint32_t)tone * 32768UL + 63UL) / 127UL);
      const uint32_t playbackFrames =
        (((uint32_t)sampleLength << 16) + sampleStep - 1) / sampleStep;
      const uint16_t decayScale = 32U +
        (((uint16_t)decay * 96U + 63U) / 127U);
      uint32_t durationFrames = (playbackFrames * decayScale) >> 7;
      if (durationFrames == 0) durationFrames = 1;
      uint16_t envelopeStep =
        (65535UL + durationFrames - 1) / durationFrames;
      if (envelopeStep == 0) envelopeStep = 1;

      ATOMIC_BLOCK(ATOMIC_RESTORESTATE) {
        drumActive = false;
        EPCW[0] = 0x8000;
        AMP[0] = 0;
        FTW[0] = 0;
        drumSampleAddress = sampleAddress;
        drumSampleLength = sampleLength;
        drumSamplePhase = 0;
        drumSampleStep = sampleStep;
        drumEnvelope = 65535;
        drumEnvelopeStep = envelopeStep;
        drumActive = sampleLength != 0;
      }
    }

    void stopDrum()
    {
      ATOMIC_BLOCK(ATOMIC_RESTORESTATE) {
        drumActive = false;
        drumSamplePhase = 0;
        drumEnvelope = 0;
      }
    }

    // A macro-controlled, 50/50 dry/wet effect with no feedback path.
    // PLAY scopes it to the three live voices; SEQ applies it to the final mix.
    void configureChorus(uint8_t mode, bool liveOnly)
    {
      const uint32_t lfoStep = mode == SYNTH_CHORUS_1 ? SYNTH_CHORUS_1_LFO_STEP :
        mode == SYNTH_CHORUS_2 ? SYNTH_CHORUS_2_LFO_STEP : 0;
      ATOMIC_BLOCK(ATOMIC_RESTORESTATE) {
        if (chorusActive != (lfoStep != 0) || chorusLiveOnly != liveOnly ||
            chorusLfoFTW != lfoStep) {
          chorusActive = lfoStep != 0;
          chorusLiveOnly = liveOnly;
          chorusWriteIndex = 0;
          chorusLfoPCW = 0;
          chorusLfoFTW = lfoStep;
        }
      }
    }

    void setDroneMode(bool enabled)
    {
      ATOMIC_BLOCK(ATOMIC_RESTORESTATE) {
        droneMode = enabled;
        if (enabled) {
          chorusActive = false;
          chorusLiveOnly = false;
          chorusLfoFTW = 0;
        }
        droneMixPair = 0;
        for (uint8_t pair = 0; pair < SYNTH_DRONE_COUNT / 2; ++pair) {
          dronePairMixQ7[pair] = 0;
          droneLfoPCW[pair] = 0;
        }
        pwmQuantizationError = 0;
      }
    }

    void setDroneWave(uint8_t voice, uint8_t wave)
    {
      if (voice >= SYNTH_DRONE_COUNT || wave == NOISE) {
        return;
      }

      const uint16_t selectedWave = waveSource(wave);
      ATOMIC_BLOCK(ATOMIC_RESTORESTATE) {
        droneWaveSources[voice] = selectedWave;
      }
    }

    void setDronePitchWord(uint8_t voice, uint16_t pitch)
    {
      if (voice >= SYNTH_DRONE_COUNT) {
        return;
      }

      ATOMIC_BLOCK(ATOMIC_RESTORESTATE) {
        droneFTW[voice] = pitch;
      }
    }

    void setDroneLfoRate(uint8_t pair, uint16_t frequencyHundredths)
    {
      if (pair >= SYNTH_DRONE_COUNT / 2) {
        return;
      }

      const uint32_t step = frequencyHundredths == 0 ? 0 :
        (uint32_t)frequencyHundredths * 8590UL;
      ATOMIC_BLOCK(ATOMIC_RESTORESTATE) {
        if (step == 0 || droneLfoFTW[pair] == 0) {
          droneLfoPCW[pair] = 0;
        }
        droneLfoFTW[pair] = step;
      }
    }

    void setDroneGate(uint8_t voice, bool enabled)
    {
      if (voice >= SYNTH_DRONE_COUNT) {
        return;
      }

      ATOMIC_BLOCK(ATOMIC_RESTORESTATE) {
        if (enabled && droneTargetAmp[voice] == 0) {
          dronePCW[voice] = 0;
        }
        droneTargetAmp[voice] = enabled ? 255 : 0;
      }
    }

    void stopAllDrones()
    {
      ATOMIC_BLOCK(ATOMIC_RESTORESTATE) {
        for (uint8_t voice = 0; voice < SYNTH_DRONE_COUNT; ++voice) {
          droneTargetAmp[voice] = 0;
          droneAmp[voice] = 0;
          dronePCW[voice] = 0;
        }
        for (uint8_t pair = 0; pair < SYNTH_DRONE_COUNT / 2; ++pair) {
          dronePairMixQ7[pair] = 0;
          droneLfoPCW[pair] = 0;
        }
      }
    }

};

#endif
