akosturi/bitsynth/(commit log)

2026-10-04 Adding noise filtering.
2026-10-07 Fixing wobbling values by adding hysteresis.
    [bitsynth.ino]
2026-10-07 More fix against wobbling.
    [bitsynth.ino]
2026-10-07 Fine tunes for wobbling issue.
    [bitsynth.ino]
2026-10-29 Adding wiring and kicad files.
